Mehmet-Emre-Dogan/NE555_PWM_Driver/README.md

# NE555_PWM_Driver
NE555 precision timer based IRFZ44N LED/motor driver design.
- No feedback loop
- Just open loop control
- No filter
- Bare PWM output
 
## PCB Design (DIP)

<div align="center">
 
### Schematic
 
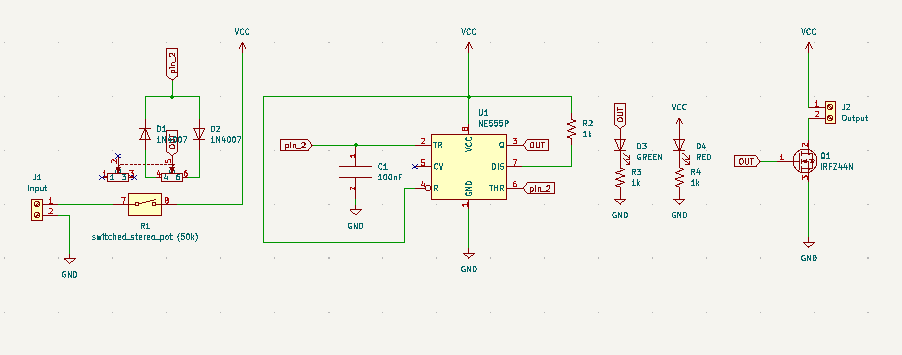
[picture p1: sch.png]


### Front
 
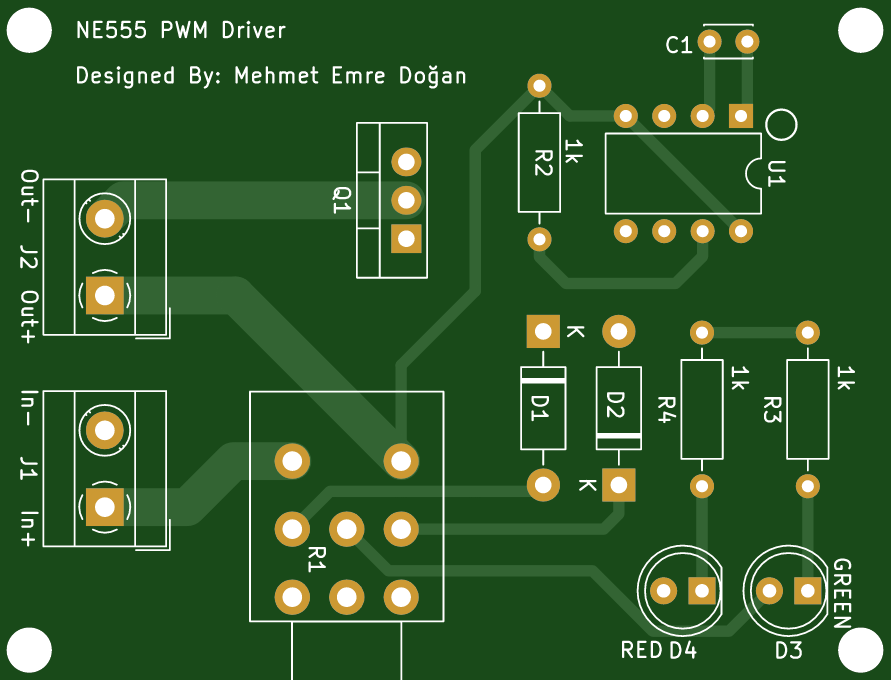
[picture p2: top.png]


### Back
 
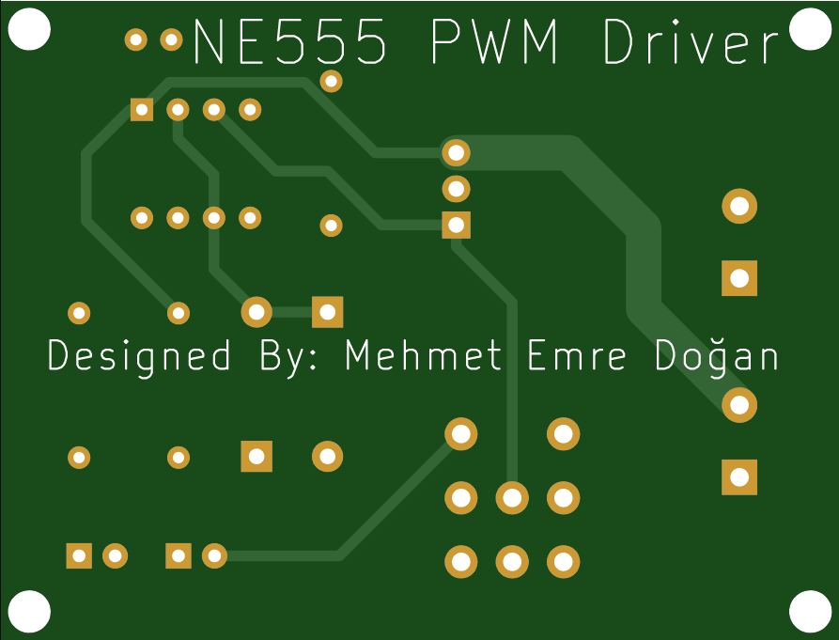
[picture p3: bottom.png]

 
 </div>

## PCB Design (SMD)

<div align="center">
 
### Schematic
 
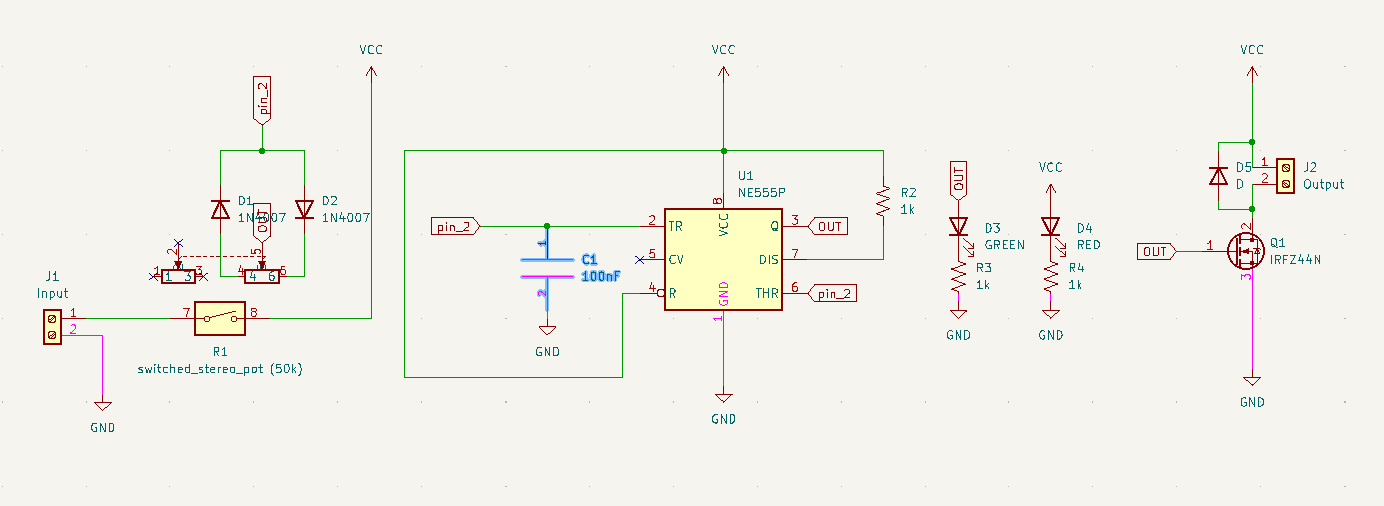
[picture p4: NE555_PWM_Driver_smd/sch.png]


### Front
 
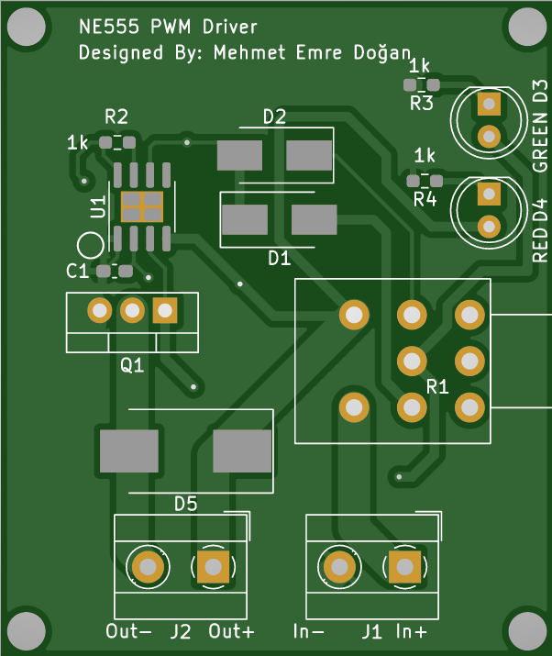
[picture p5: NE555_PWM_Driver_smd/top.png]


### Back
 
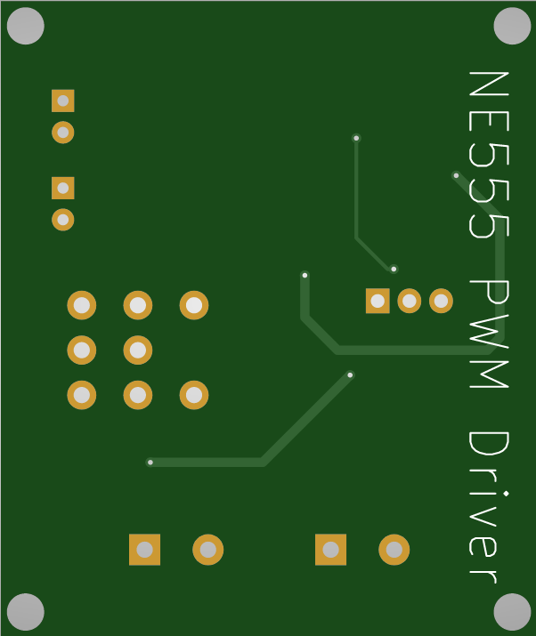
[picture p6: NE555_PWM_Driver_smd/bottom.png]

 
 </div>

## PCB Images (SMD)

<div align="center">
 
### With Lamp
 
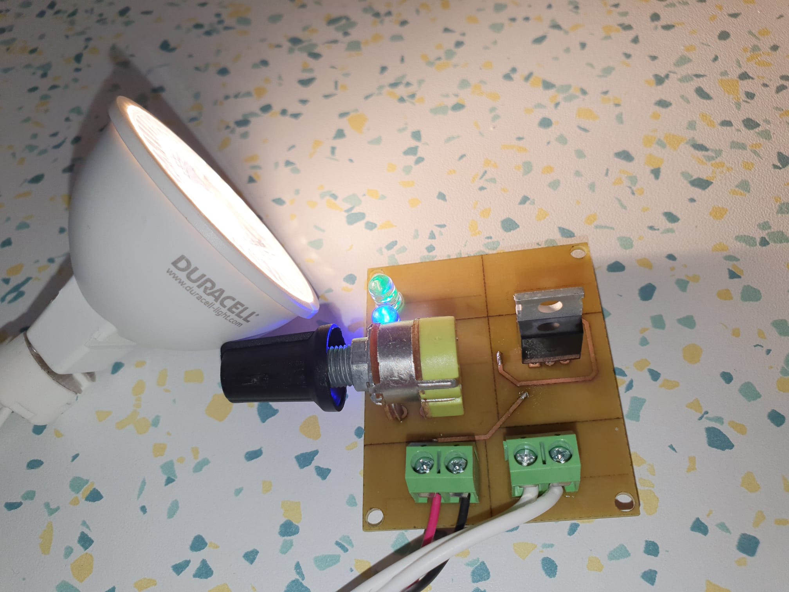
[picture p7: withLoad.jpeg]
with load


### Front
 
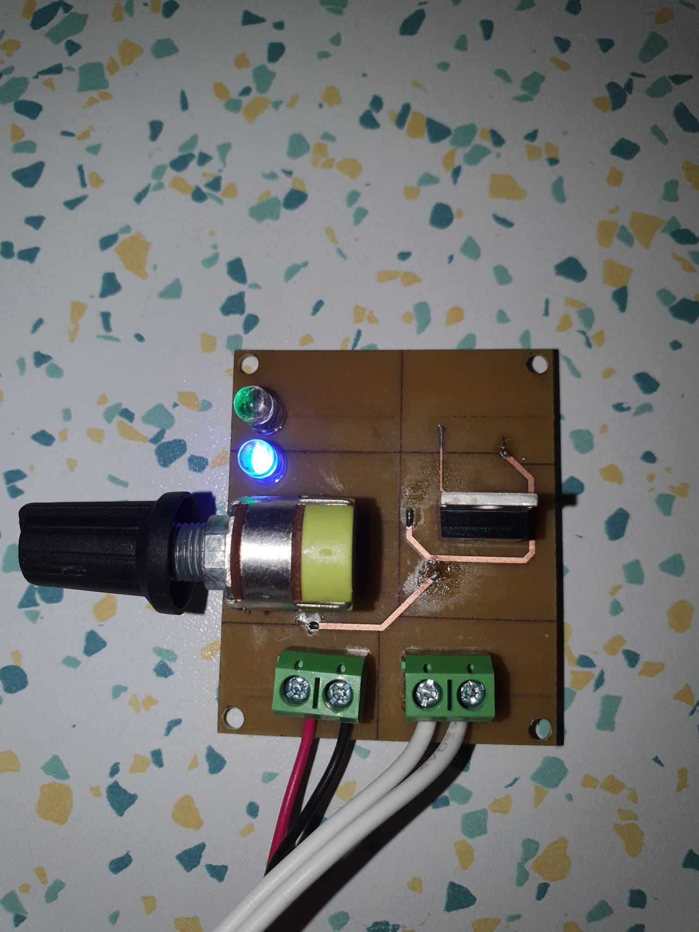
[picture p8: topPcb.jpeg]


### Back
 
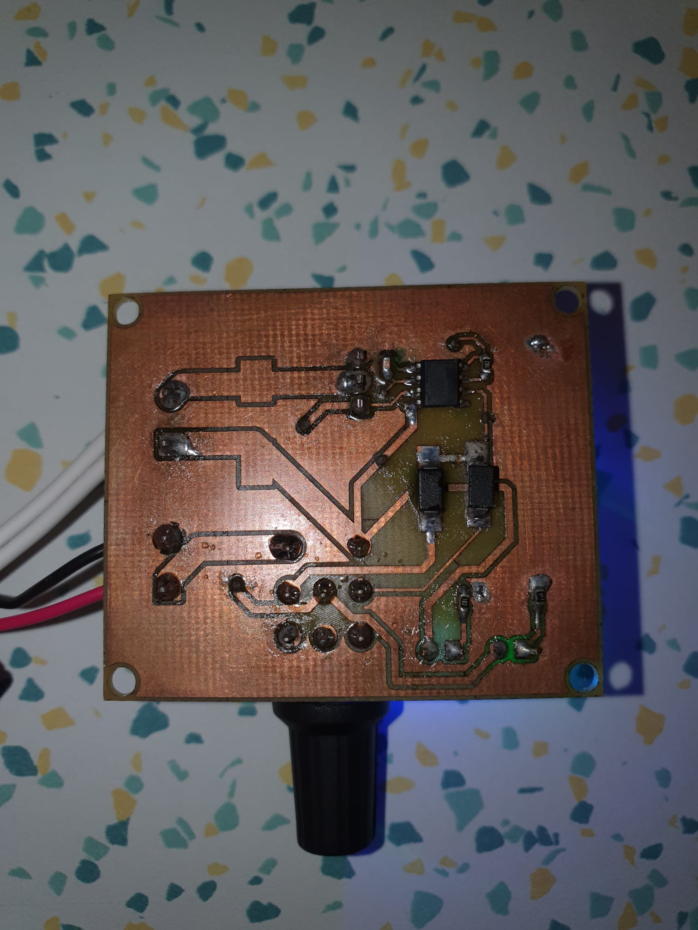
[picture p9: bottomPcb.jpeg]

 
 </div>

## Oscilloscope Waveforms

<div align="center">

### General

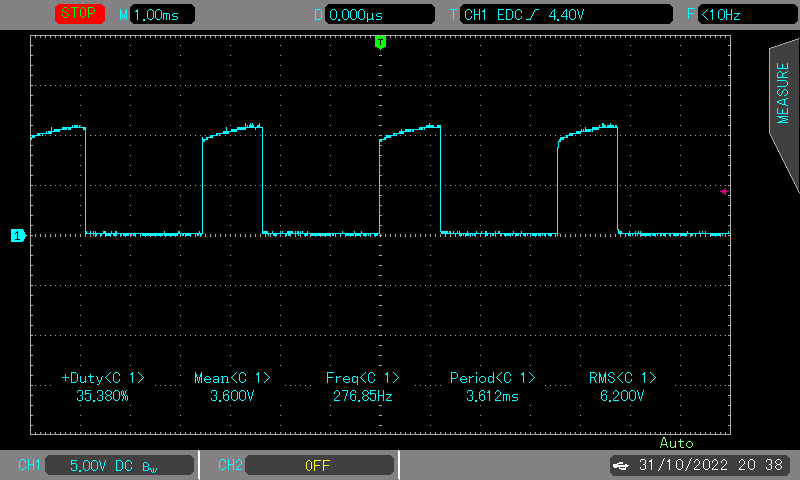
[picture p10: smdScopePics/scope.BMP]
scope


### Whole Swing

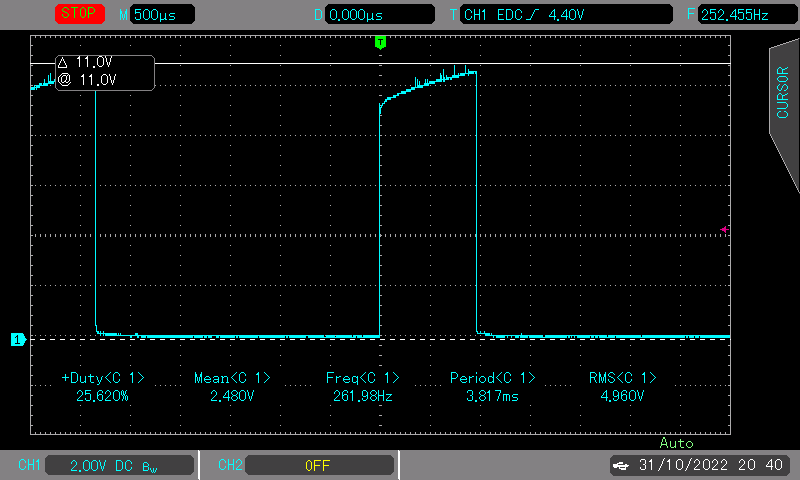
[picture p11: smdScopePics/wholeSwing.BMP]
scope


### Ripple

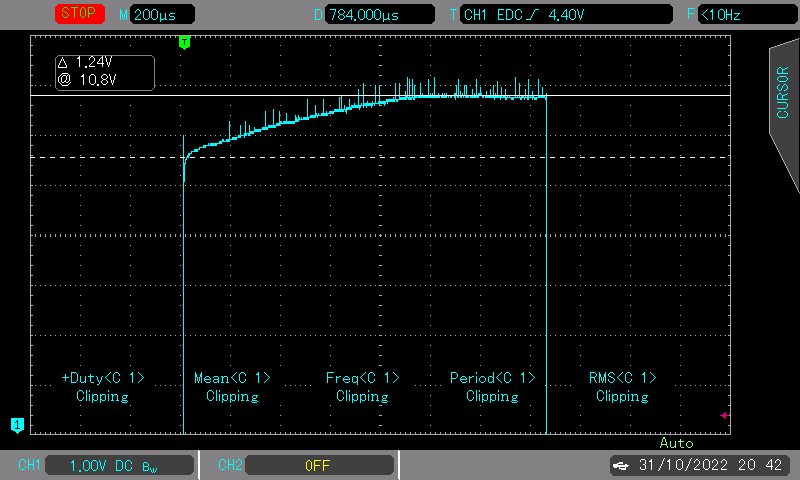
[picture p12: smdScopePics/ripple.BMP]
scope


### Noise

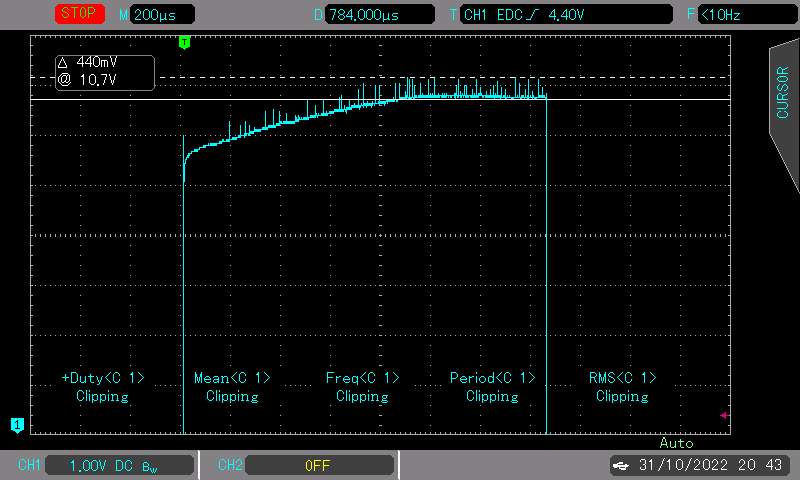
[picture p13: smdScopePics/noise.BMP]
scope


 </div>

 ### Conclusion

 - The theoratical frequency is consistent with experimental frequency
 - There is small discrepancies between the theoratical ripple and experimental ripple

## Simulation on LTSpice
  
 <div align="center">
 
### Circuit
 
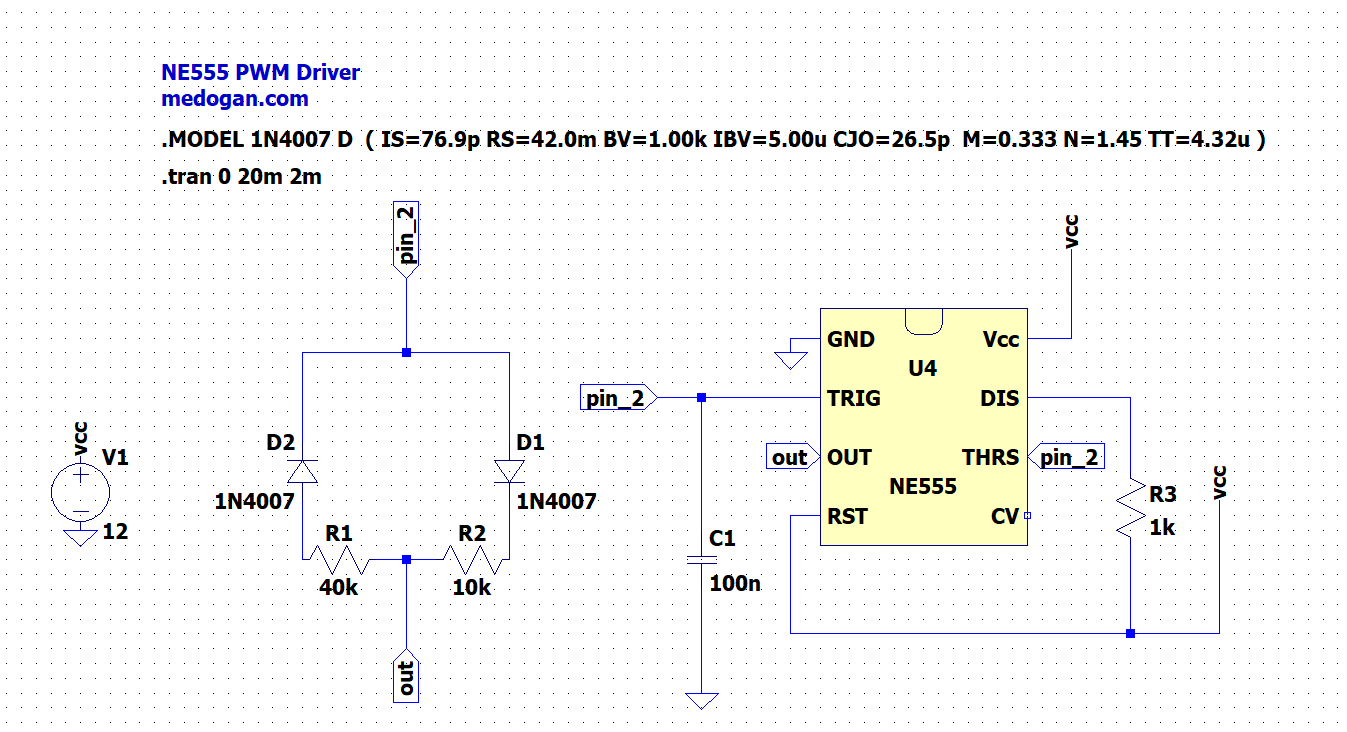
[picture p14: SPICE/sim_sch.png]
cct


### Waveforms
 
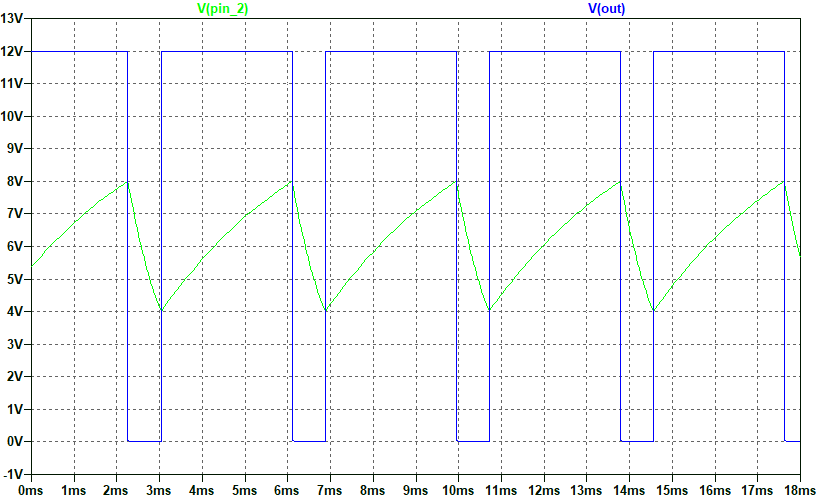
[picture p15: SPICE/sim_wvf.png]
wvf

 
 </div>
 
 ## Prototype on Breadboard
  
 <div align="center">
 
 ### [Watch the video](https://youtu.be/RiIcqe25NVU)
 
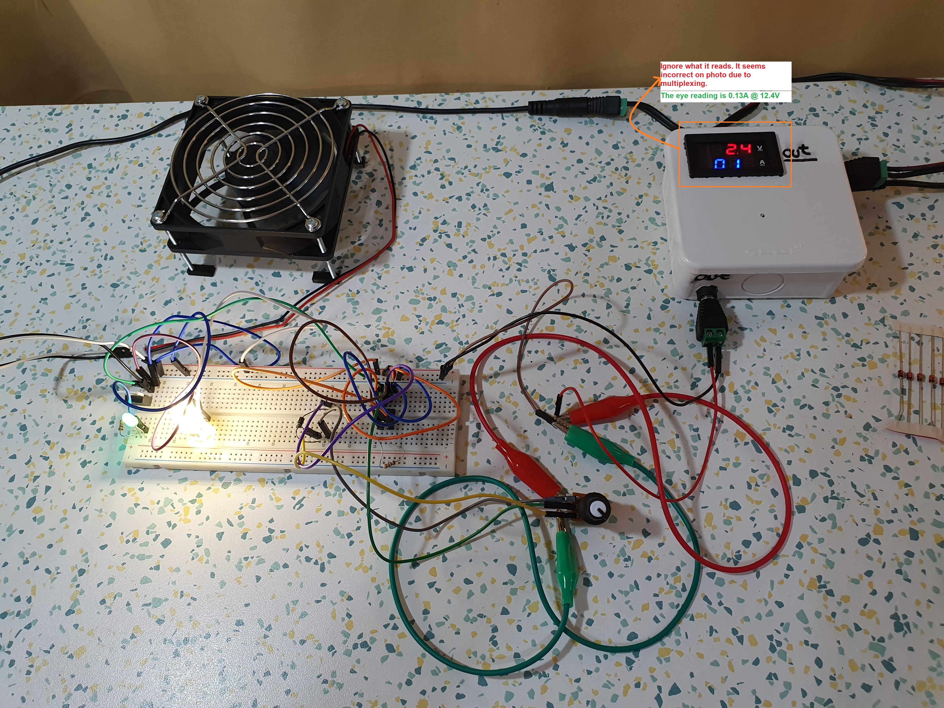
[picture p16: prototype.jpg]
prototype

 
 </div>

 ## References
https://circuitdigest.com/electronic-circuits/555-timer-pwm-generator-circuit
