Mehmet-Emre-Dogan/NE555_PWM_Driver/ytThumbnail.jpg

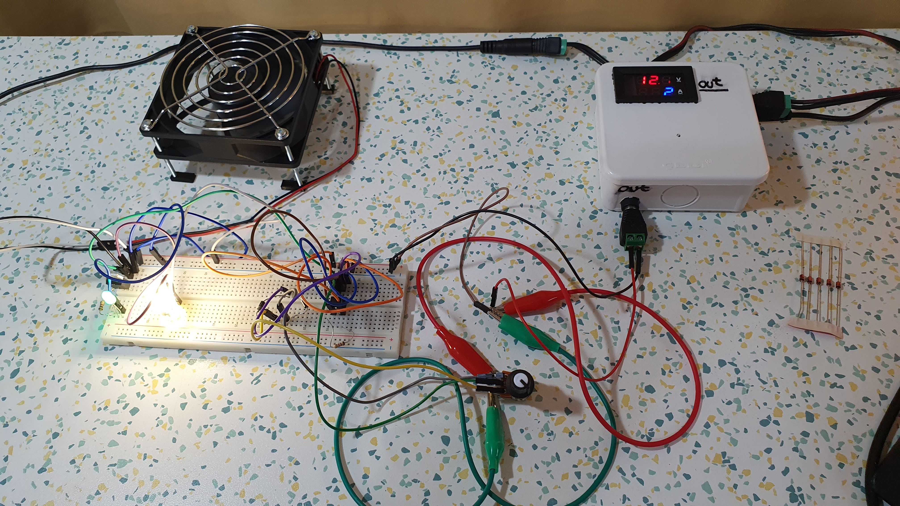
ytThumbnail.jpg
