Mehmet-Emre-Dogan/NE555_PWM_Driver/SPICE/pwm.asc

C1: cap; 100n
D1: diode; 1N4007
D2: diode; 1N4007
R1: res; 40k
R2: res; 10k
R3: res; 1k
U4: NE555
V1: voltage; 12
Named nets: 0, vcc, pin_2, out
.tran 0 20m 2m
.MODEL 1N4007 D  ( IS=76.9p RS=42.0m BV=1.00k IBV=5.00u CJO=26.5p  M=0.333 N=1.45 TT=4.32u )
NE555 PWM Driver
medogan.com
