Mehmet-Emre-Dogan/NE555_PWM_Driver/NE555_PWM_Driver_smd/NE555_PWM_Driver.kicad_pcb

## KiCad design NE555_PWM_Driver_smd/NE555_PWM_Driver.kicad_pcb (2022-08-06)

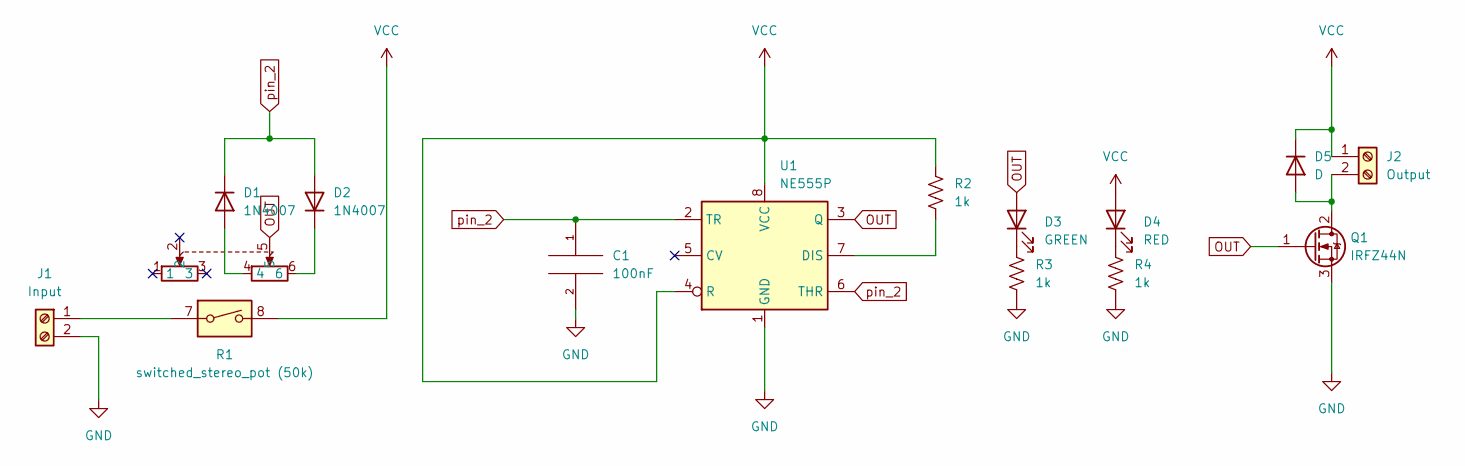
[picture p18: schematic NE555_PWM_Driver.kicad_sch, NE555 Based PWM Driver]

Parts:
C1: 100nF; C_0603_1608Metric_Pad1.08x0.95mm_HandSolder
D1, D2: 1N4007; D_SMB_Handsoldering
D3: GREEN; LED_D5.0mm_Clear
D4: RED; LED_D5.0mm_Clear
D5: D; D_SMC_Handsoldering
J1: Input; TerminalBlock_MetzConnect_Type101_RT01602HBWC_1x02_P5.08mm_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
J2: Output; TerminalBlock_MetzConnect_Type101_RT01602HBWC_1x02_P5.08mm_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
Q1: IRFZ44N; TO-220-3_Vertical
R1: switched_stereo_pot (50k); stereo_pot_with_switch
R2, R3, R4: 1k; R_0603_1608Metric_Pad0.98x0.95mm_HandSolder
U1: NE555P; SOIC-8-1EP_3.9x4.9mm_P1.27mm_EP2.41x3.3mm

Connections:
GND: C1.2, J1.2, Q1.3 (S), R3.2, R4.2, U1.1 (GND)
unnamed: D1.2 (A), R1.4
unnamed: D2.1 (K), R1.6
unnamed: D3.1 (K), R3.1
unnamed: D4.1 (K), R4.1
unnamed: D5.2 (A), J2.2, Q1.2 (D)
unnamed: J1.1, R1.7
unnamed: R2.2, U1.7 (DIS)
OUT: D3.2 (A), Q1.1 (G), R1.5, U1.3 (Q)
VCC: D4.2 (A), D5.1 (K), J2.1, R1.8, R2.1, U1.4 (R), U1.8 (VCC)
pin_2: C1.1, D1.1 (K), D2.2 (A), U1.2 (TR), U1.6 (THR)

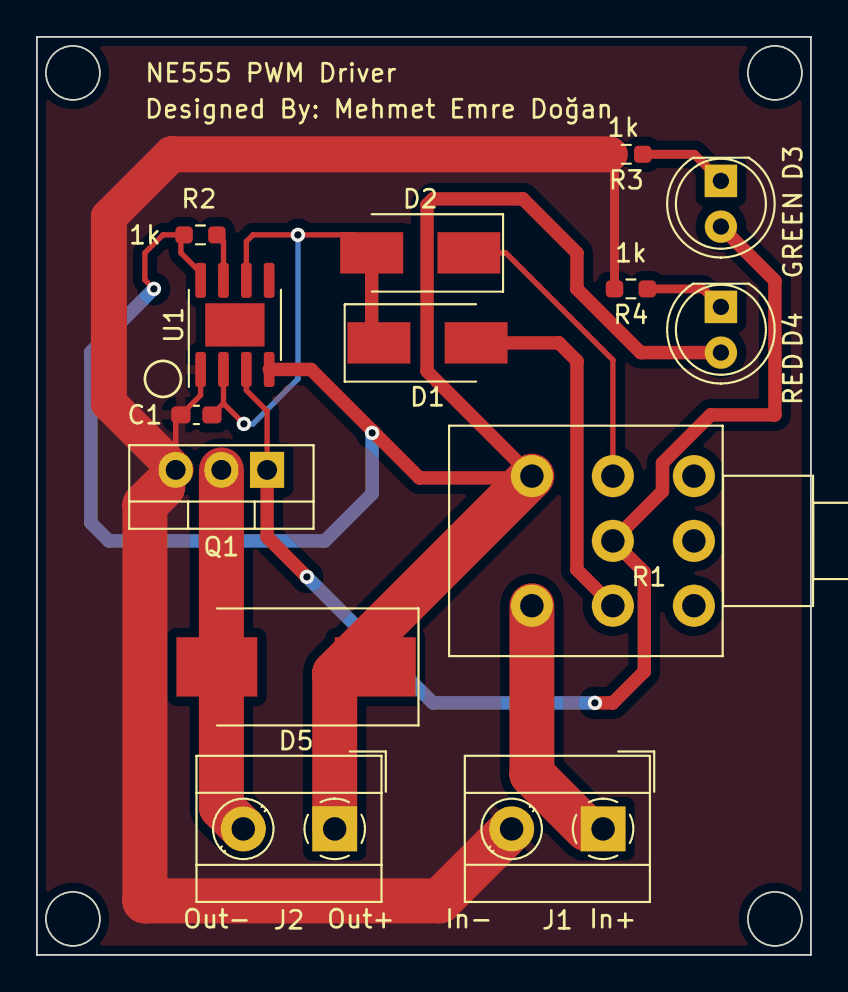
[picture p19: board NE555_PWM_Driver.kicad_pcb from above]

Board: 2 copper layers, 43.0 x 51.0 mm, 14 parts (0 on the bottom side), 11 nets.
