Mehmet-Emre-Dogan/NE555_PWM_Driver/(commit log)

2022-03-19 finished design
    [NE555_PWM_Driver-B_Cu.gbr, NE555_PWM_Driver-B_Mask.gbr, NE555_PWM_Driver-B_Paste.gbr, NE555_PWM_Driver-B_Silkscreen.gbr, NE555_PWM_Driver-Edge_Cuts.gbr, NE555_PWM_Driver-F_Cu.gbr, NE555_PWM_Driver-F_Mask.gbr, NE555_PWM_Driver-F_Paste.gbr]
2022-03-20 added i/o polarity on silkscreen
    [NE555_PWM_Driver-B_Cu.gbr, NE555_PWM_Driver-B_Mask.gbr, NE555_PWM_Driver-B_Paste.gbr, NE555_PWM_Driver-B_Silkscreen.gbr, NE555_PWM_Driver-Edge_Cuts.gbr, NE555_PWM_Driver-F_Cu.gbr, NE555_PWM_Driver-F_Mask.gbr, NE555_PWM_Driver-F_Paste.gbr]
2022-07-31 designed SDM version of the card
    [NE555_PWM_Driver-B_Cu.gbr, NE555_PWM_Driver-B_Mask.gbr, NE555_PWM_Driver-B_Paste.gbr, NE555_PWM_Driver-B_Silkscreen.gbr, NE555_PWM_Driver-Edge_Cuts.gbr, NE555_PWM_Driver-F_Cu.gbr, NE555_PWM_Driver-F_Mask.gbr, NE555_PWM_Driver-F_Paste.gbr]
2022-08-06 filled top plane with ground
    [NE555_PWM_Driver-B_Cu.gbr, NE555_PWM_Driver-B_Mask.gbr, NE555_PWM_Driver-B_Paste.gbr, NE555_PWM_Driver-B_Silkscreen.gbr, NE555_PWM_Driver-Edge_Cuts.gbr, NE555_PWM_Driver-F_Cu.gbr, NE555_PWM_Driver-F_Mask.gbr, NE555_PWM_Driver-F_Paste.gbr]
2022-10-31 add pcb photos
