Mehmet-Emre-Dogan/NE555_PWM_Driver/(notices)

Notices in the files:
NE555_PWM_Driver/NE555_PWM_Driver.kicad_sch:
creativecommons.org/licenses/by/4.0
License: CC BY 4.0
